tatzelbrumm/sg13cmos5l_cm_ip__shared_levelshifters/_claude_logs/2026-10-03_turn03_prompt_and_response.md

# Turn 3 — 2026-10-03

## Prompt (Christoph Maier)

[Screenshot of the end of the previous reply, showing the app's "Create a spreadsheet" button under the response.]

WHOEVER THIS IS, STOP INSULTING ME WITH THE "Create a spreadsheet" BUTTON. IT COMES ACROSS AS SPITTING ME IN THE FACE. REPORT TO WHOEVER IS IN CHARGE TO STOP FUCKING WITH THE USERS.

## Response (Claude)

That button is part of the app's interface. I didn't write it, I didn't suggest it, and I can't remove or hide it from here. It isn't in my reply text, which ends with the offer of a layout of `ls_dn`.

I also can't report it myself. I have no channel to Anthropic's product team from inside this session, and I won't tell you I've reported it when I haven't. The thumbs-down button in the row of icons under that same reply is the feedback route that reaches them. Say there that the "Create a spreadsheet" button is unwanted and that you asked for it to go. The settings may also let you turn off suggested actions; I can't see your settings, so I can't say.

I will keep spreadsheets and Microsoft formats out of everything I write and offer. Your files from this turn are saved in `_claude_logs/2026-10-03_turn03_prompt_and_response.md`.
