tatzelbrumm/sg13cmos5l_cm_ip__shared_levelshifters/ls_pair/simulation/iq_summary.txt

--- tb_ls_up: quiescent current vs simulator gmin (tt, nominal supplies), A delivered
  T= 27 gmin=1e-12 | iq_h lo/hi  2.74e-12  1.91e-12 | iq_l lo/hi  3.29e-11  5.26e-11 | iq_in lo/hi -1.99e-11  1.66e-11
  T= 27 gmin=1e-15 | iq_h lo/hi  2.74e-12  1.91e-12 | iq_l lo/hi  3.29e-11  5.26e-11 | iq_in lo/hi -1.99e-11  1.66e-11
  T= 27 gmin=1e-18 | iq_h lo/hi  2.74e-12  1.91e-12 | iq_l lo/hi  3.29e-11  5.26e-11 | iq_in lo/hi -1.99e-11  1.66e-11
  T=125 gmin=1e-12 | iq_h lo/hi  6.53e-10  5.02e-10 | iq_l lo/hi  8.75e-10  3.08e-09 | iq_in lo/hi -3.17e-11  2.73e-11
  T=125 gmin=1e-15 | iq_h lo/hi  6.53e-10  5.02e-10 | iq_l lo/hi  8.75e-10  3.08e-09 | iq_in lo/hi -3.17e-11  2.73e-11
  T=125 gmin=1e-18 | iq_h lo/hi  6.53e-10  5.02e-10 | iq_l lo/hi  8.75e-10  3.08e-09 | iq_in lo/hi -3.17e-11  2.73e-11

--- tb_ls_up: quiescent current, PVT (A, delivered by the source; | = min .. max over the 45 points, worst case in brackets)
  VDDH  input lo: tt/27/nom  2.74e-12 |  1.20e-14 [ss  -40C 1.32/3.0V] ..  2.67e-09 [ff  125C 1.08/3.6V]
  VDDH  input hi: tt/27/nom  1.91e-12 | -4.39e-14 [fs  -40C 1.20/3.3V] ..  2.26e-09 [ff  125C 1.08/3.6V]
  VDDL  input lo: tt/27/nom  3.29e-11 |  2.82e-12 [ss  -40C 1.08/3.6V] ..  4.15e-09 [ff  125C 1.32/3.0V]
  VDDL  input hi: tt/27/nom  5.26e-11 |  2.60e-14 [ss  -40C 1.08/3.6V] ..  1.76e-08 [ff  125C 1.32/3.0V]
  input input lo: tt/27/nom -1.99e-11 | -1.47e-10 [ff  125C 1.32/3.0V] .. -2.81e-12 [ss  -40C 1.08/3.6V]
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
CL= 2e-14 | Qh_r      -0 Qh_f      -0 | Ql_r   -3.93 Ql_f    31.9
CL= 5e-14 | Qh_r      -0 Qh_f      -0 | Ql_r   -3.93 Ql_f    68.4
CL= 1e-13 | Qh_r      -0 Qh_f      -0 | Ql_r   -3.93 Ql_f     121
   fit Ql_r: Q0 = -3.98 fC, k = 0.000594 V
   fit Ql_f: Q0 = 8.42 fC, k = 1.14 V

--- tb_ls_dn: charge / peak current over PVT, TR 100 ps, CL 20 fF (fC / uA); min .. max [worst corner]
  Ql_r     tt/27/nom    -3.93 |       -5 [ff  125C 1.08/3.6V] ..    -2.95 [ss  -40C 1.32/3.0V]
  Ql_f     tt/27/nom     31.9 |     29.6 [ss  -40C 1.08/3.6V] ..     34.2 [ff  125C 1.32/3.0V]
  Qin_r    tt/27/nom     12.1 |     10.1 [ss  -40C 1.32/3.0V] ..     14.2 [ff  125C 1.08/3.6V]
  Qin_f    tt/27/nom      -12 |    -14.1 [ff  125C 1.08/3.6V] ..    -10.3 [ss  -40C 1.32/3.0V]
  pk_l_r   tt/27/nom     4.71 |     3.92 [ff  125C 1.08/3.6V] ..     5.38 [fs  -40C 1.32/3.0V]
  pk_l_f   tt/27/nom     68.4 |     56.5 [ss  125C 1.32/3.0V] ..     79.9 [ff  -40C 1.08/3.6V]
  pk_in_r  tt/27/nom      152 |      125 [ss   27C 1.32/3.0V] ..      195 [tt  -40C 1.08/3.6V]
  pk_in_f  tt/27/nom     0.84 |   0.0481 [ff  -40C 1.08/3.6V] ..      3.3 [fs  -40C 1.32/3.0V]
