tatzelbrumm/sg13cmos5l_cm_ip__shared_levelshifters/ls_pair/simulation/iq_results.ods

Sheet: Notes
Notes
Level shifters ls_up_1v2_3v3 and ls_dn_3v3_1v2, IHP SG13CMOS5L, ngspice + PSP103, pre-layout, no parasitics.
Sign: positive current/charge = delivered BY the source. Charge net of pre-edge baseline current, window = edge start .. 10 ns after the input is done.
Rise/fall refer to the INPUT edge. CL = 20 fF unless stated; TR sweep at tt, 27 C, VDDL 1.2 V, VDDH 3.3 V.
PVT sheets: 5 MOS corners x -40/27/125 C x (VDDL,VDDH) = (1.08,3.6), (1.2,3.3), (1.32,3.0); TR = 100 ps.
Quiescent values at pA/fA level are model-limited (checked against simulator gmin 1e-12/1e-15/1e-18: no change).
ls_dn has no VDDH: VDDH columns are empty for it.
Point VDDL=1.08 V, sf, -40 C of ls_up has delays of 6-9 ns: edge of the working range.
Source: scripts/run_iq.py, scripts/analyze_iq.py, simulation/iq_*.json; generated by scripts/gen_ods.py.
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
