tatzelbrumm/sg13cmos5l_cm_ip__shared_levelshifters/(commit log)

2026-10-04 ls_pair : Claude Sonnet 5.5 High's pick for level shifters
    [ls_dn_3v3_1v2.sch, ls_up_1v2_3v3.sch, tb_ls_dn.sch, tb_ls_loop.sch, tb_ls_up.sch]
2026-10-04 xschem/ls*.sch : hand edit level shifter xschem schematics
    [ls_dn_3v3_1v2.sch, ls_up_1v2_3v3.sch]
2026-10-04 ls_pair : updated by Claude Sonnet in response to hand drawn xschem schematics, find xschem symbols for level shifters
    [tb_ls_dn.sch, tb_ls_loop.sch, tb_ls_up.sch]
2026-10-04 ls_pair/tb/tb_ls_*.sch : hand drawn test base schematics
    [tb_ls_dn.sch, tb_ls_loop.sch, tb_ls_up.sch]
2026-10-04 ls_pair : thorough test of level shifter
    [iq_results.ods]
2026-10-04 _claude_logs/turn09_skill_proposal : refine schematic drawing skill based on hand edited schematics
